jlpoltrack/mLRS-433-DIY/Renders/Back.png

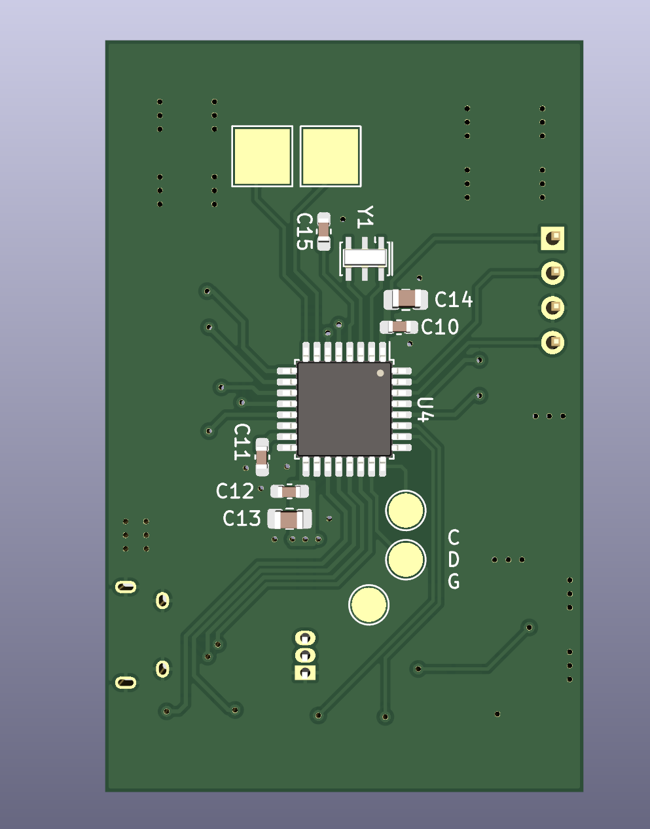
Renders/Back.png
