jlpoltrack/mLRS-433-DIY/Renders/Front.png

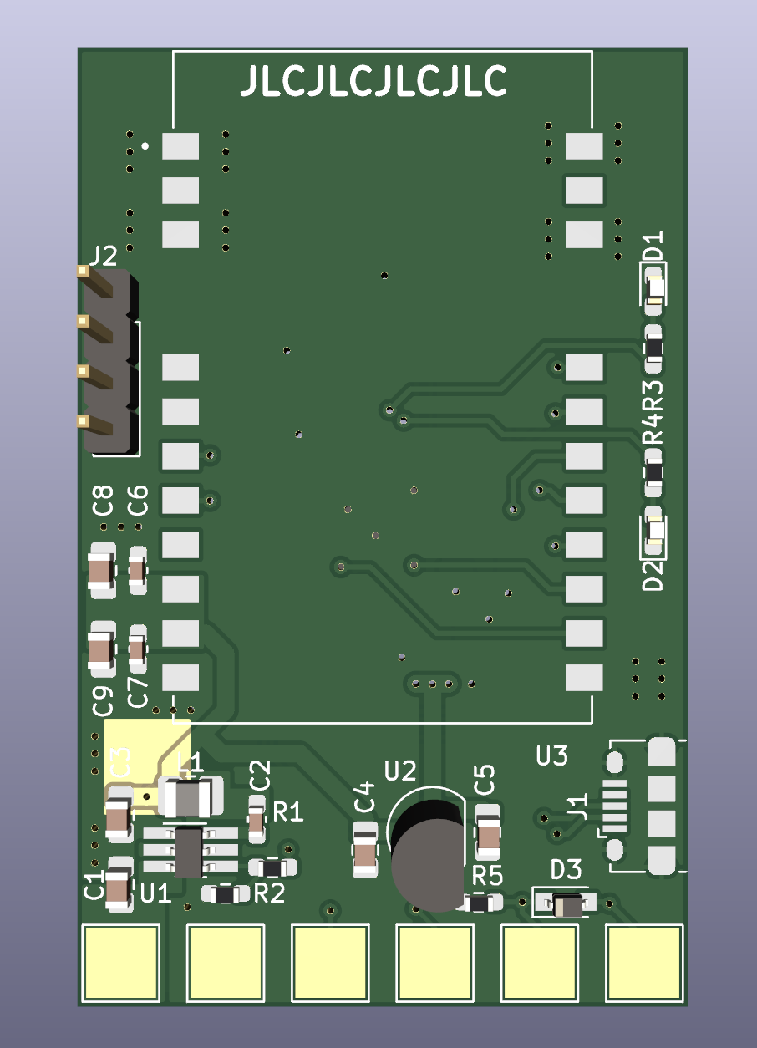
Renders/Front.png
