jlpoltrack/mLRS-433-DIY/E22/E22-900M30S.step

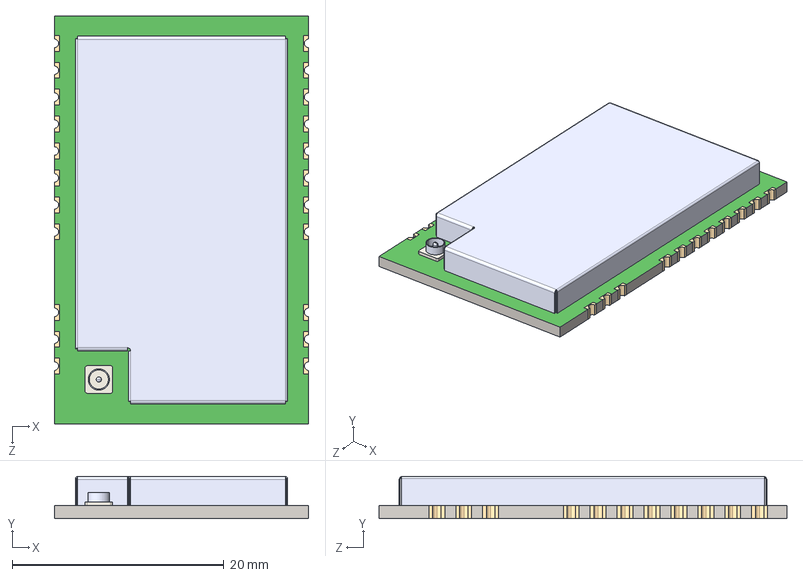
[picture p3: CAD file, 2023-05-28]
E22/E22-900M30S.step
24.0 x 3.97 x 38.5 mm
