jlpoltrack/mLRS-433-DIY/Schematic.pdf

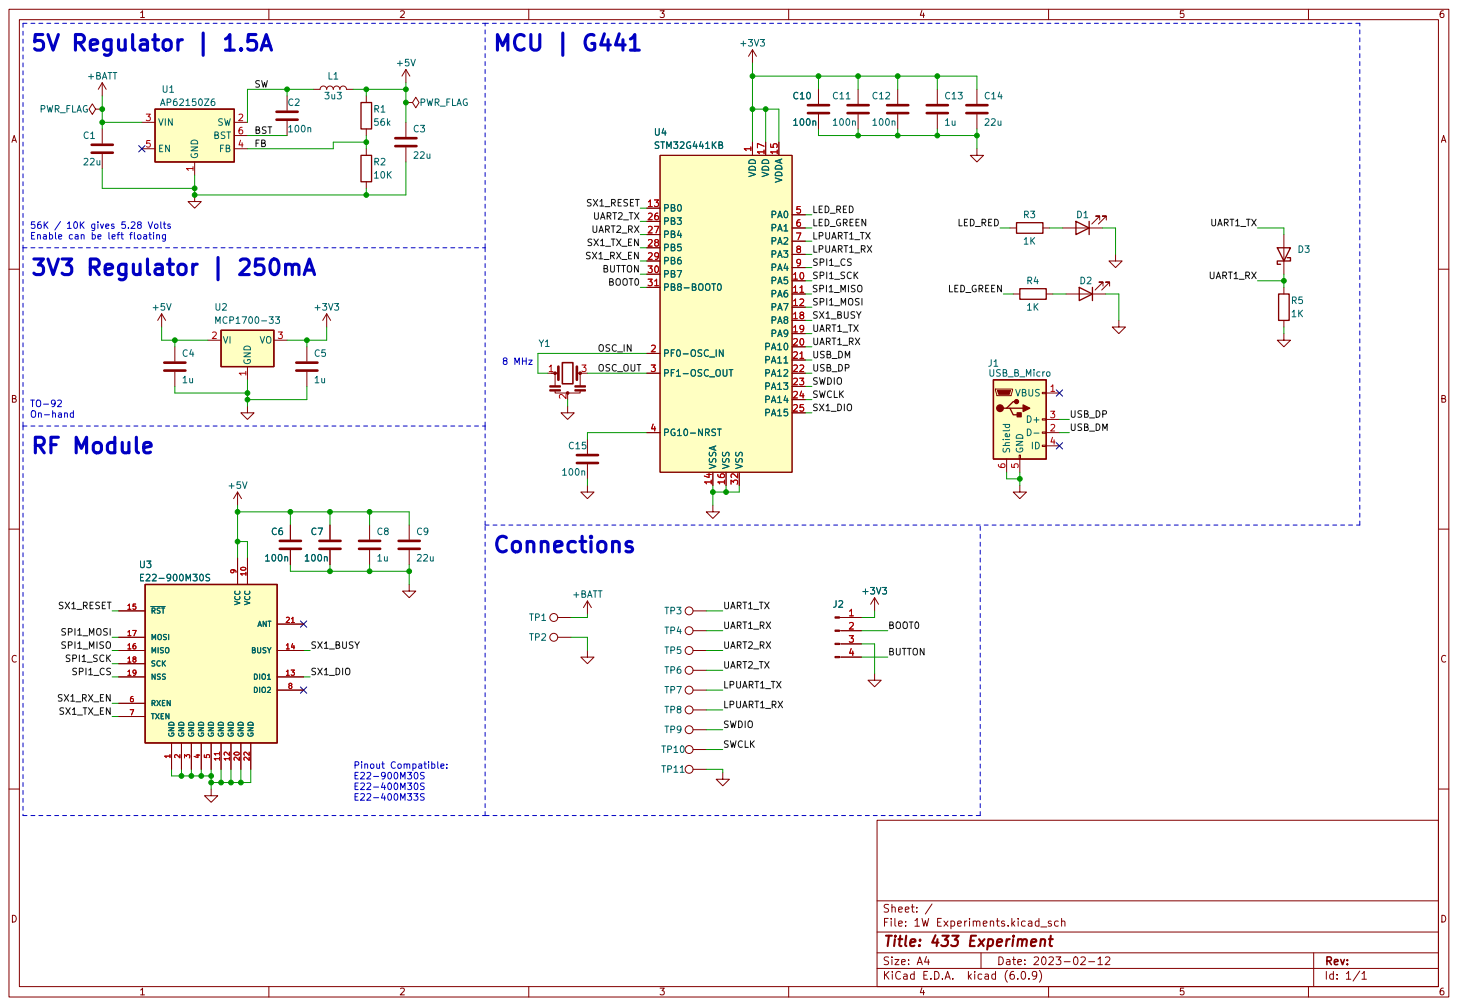
[picture p4: page 1]

Enable can be left floating TO-92 On-hand RF Module
LPUART1_RX 3V3 Regulator | 250mA

1 SW 2 VIN 3 FB 4 EN 5 BST 6 U1AP62150Z6 TP5 TP1 TP2

1 PA5 10 PA6 11 PA7 12 PB0 13 VSSA 14 VDDA 15 VSS 16 VDD 17 PA8 18 PA9 19 PF0-OSC_IN 2 PA10 20 PA11 21 PA12 22 PA13 23 PA14 24 PA15 25 PB3 26 PB4 27 PB5 28 PB6 29 PF1-OSC_OUT 3 PB7 30 PB8-BOOT0 31 VSS 32 PG10-NRST 4 PA0 5 PA1 6 PA2 7 PA3 8 PA4 9 U4STM32G441KB C13

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

1 VCC 10 GND 11 GND 12 DIO1 13 BUSY 14 ~{RST} 15 MISO 16 MOSI 17 SCK 18 NSS 19 GND

2 GND 20 ANT 21 GND 22 GND
