jlpoltrack/mLRS-433-DIY/E22/Schematic 0.1.pdf

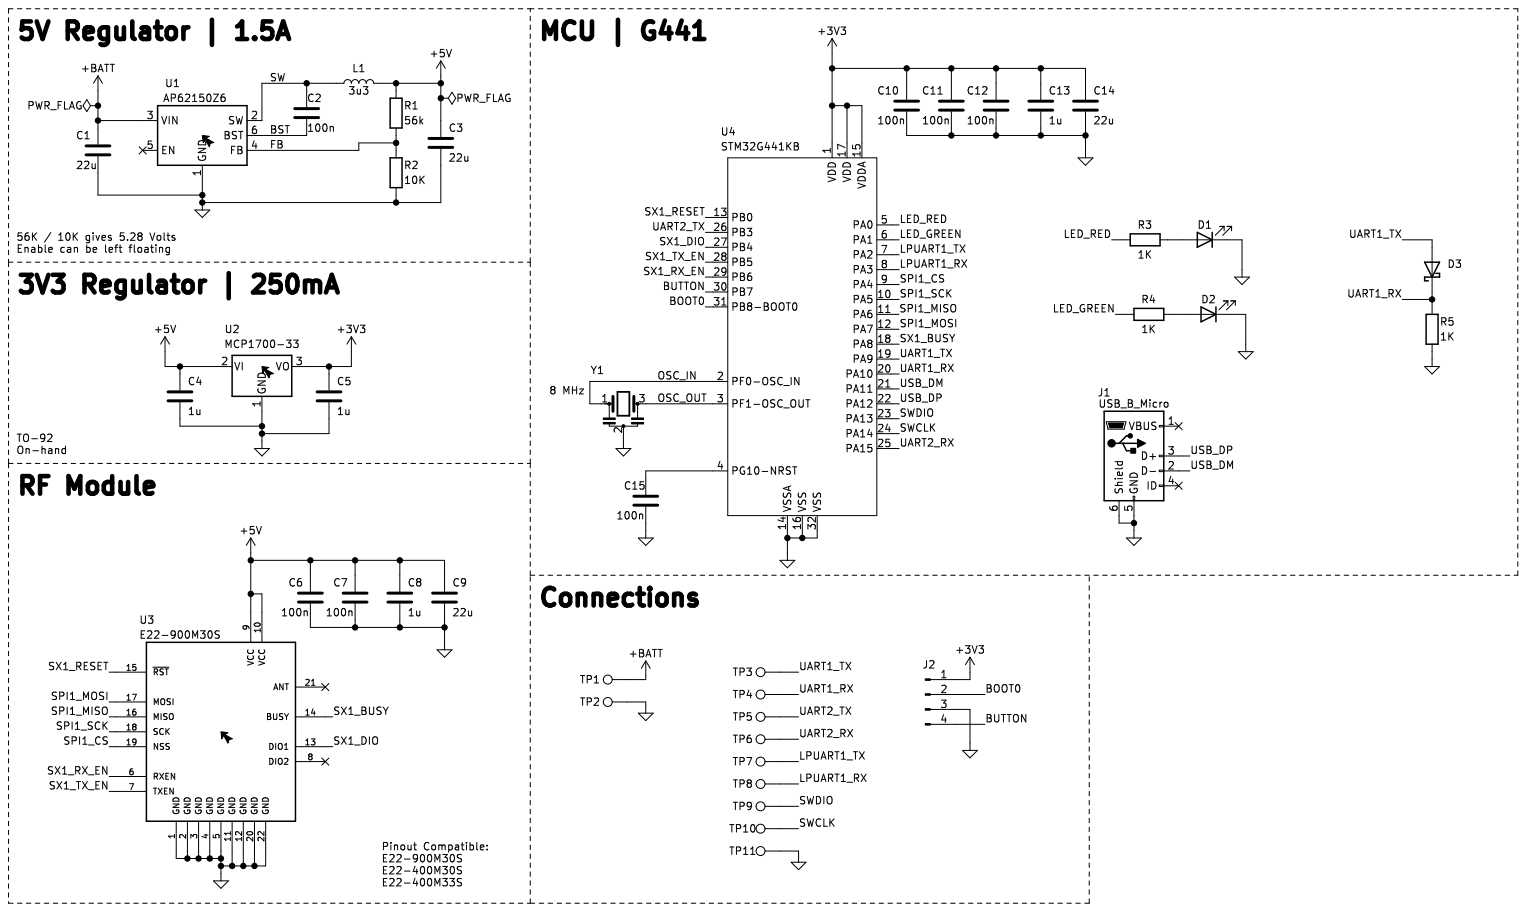
[picture p5: page 1]
