jlpoltrack/mLRS-433-DIY/1W Experiments.kicad_pcb

## KiCad design 1W Experiments.kicad_pcb (2023-05-28)

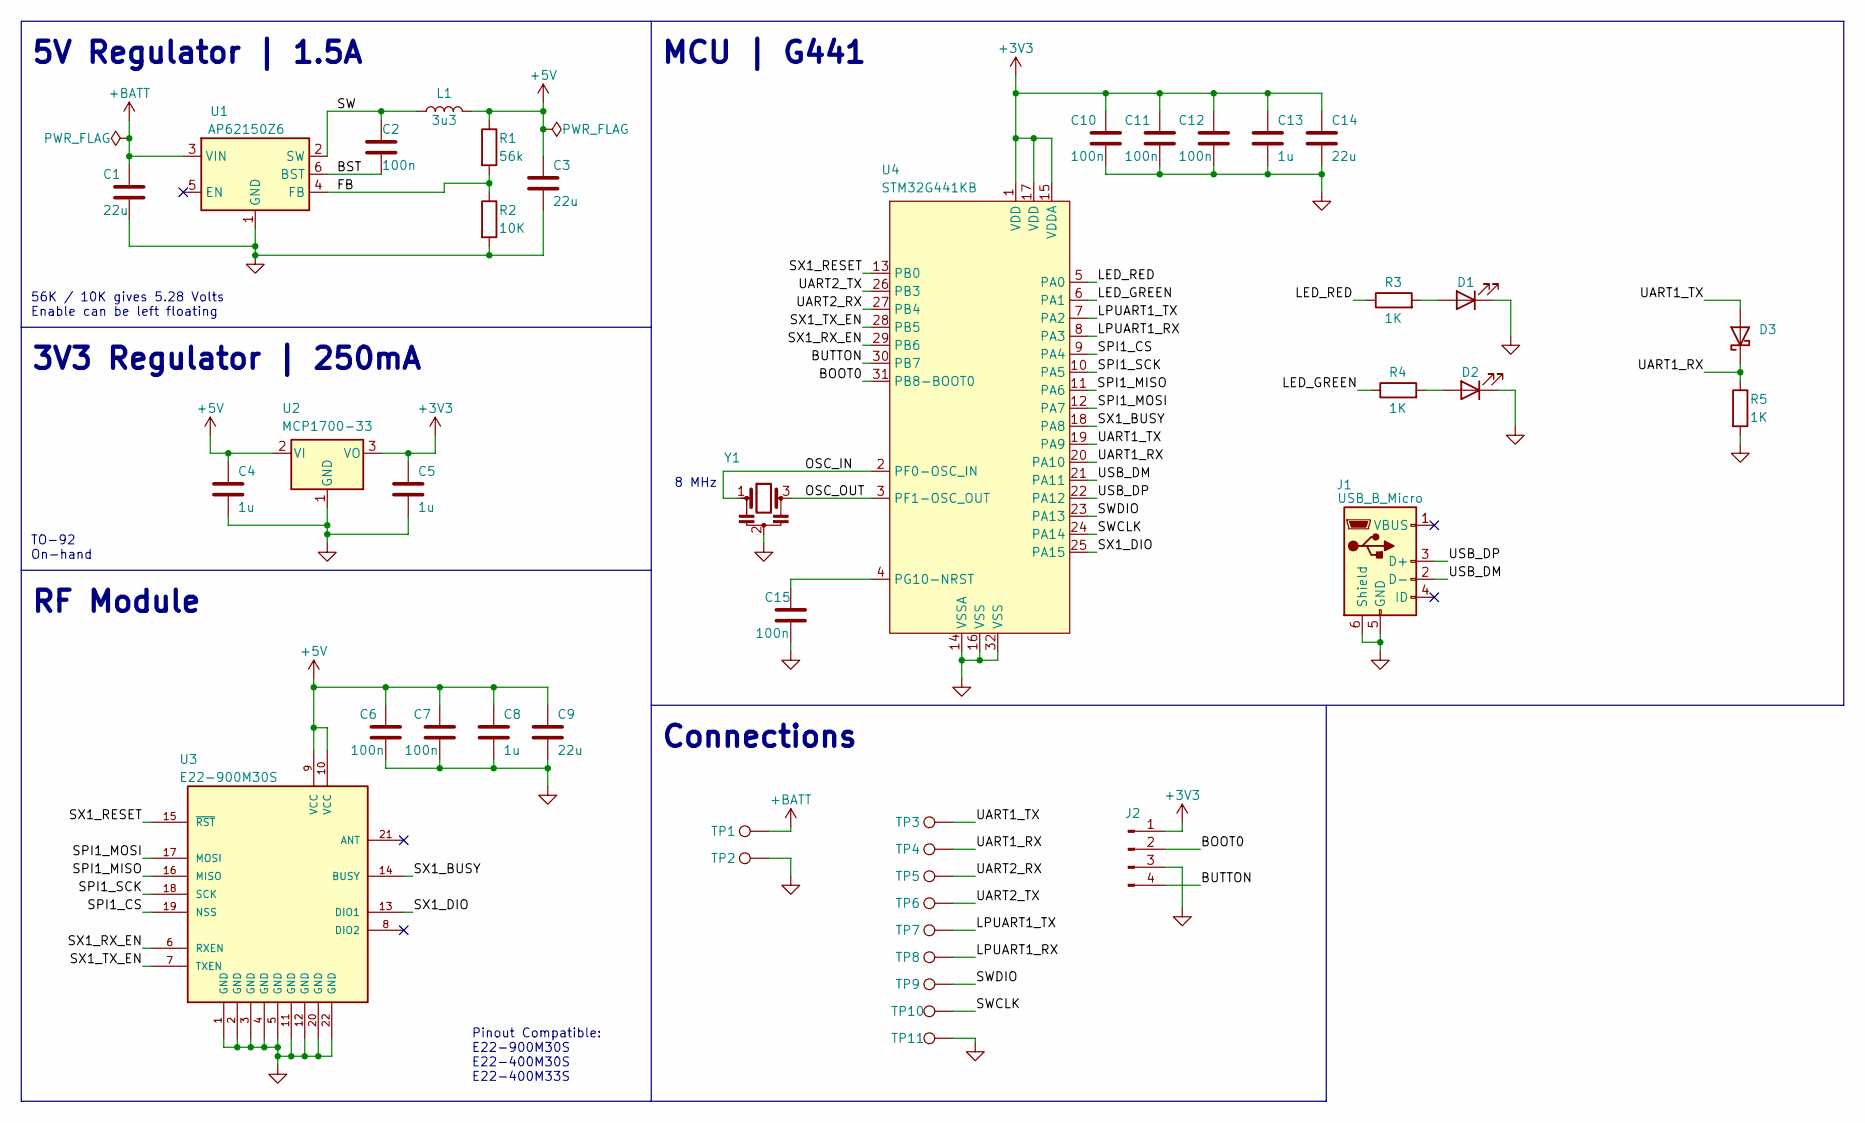
[picture p6: schematic 1W Experiments.kicad_sch, 433 Experiment]

Parts:
C1, C3, C9, C14: 22u; C_0805_2012Metric_Pad1.18x1.45mm_HandSolder
C2, C6, C7, C10, C11, C12, C15: 100n; C_0603_1608Metric_Pad1.08x0.95mm_HandSolder
C4, C5, C8, C13: 1u; C_0805_2012Metric_Pad1.18x1.45mm_HandSolder
D1, D2: LED; LED_0603_1608Metric_Pad1.05x0.95mm_HandSolder
D3: D_Schottky; D_SOD-323_HandSoldering
J1: USB_B_Micro; USB_Micro-B_Amphenol_10118194_Horizontal
J2: Conn_01x04_Male; PinHeader_1x04_P2.54mm_Vertical
L1: 3u3; L_1008_2520Metric_Pad1.43x2.20mm_HandSolder
R1: 56k; R_0603_1608Metric_Pad0.98x0.95mm_HandSolder
R2: 10K; R_0603_1608Metric_Pad0.98x0.95mm_HandSolder
R3, R4, R5: 1K; R_0603_1608Metric_Pad0.98x0.95mm_HandSolder
TP1, TP2, TP3, TP4, TP5, TP6, TP7, TP8: TestPoint; TestPoint_Pad_4.0x4.0mm
TP9, TP10, TP11: TestPoint; TestPoint_Pad_D2.5mm
U1: AP62150Z6; TSOT-23-6_HandSoldering
U2: MCP1700-33; TO-92_Inline
U3: E22-900M30S; XCVR_E22-900M30S; PARTREV 1.2
U4: STM32G441KB; LQFP-32_7x7mm_P0.8mm
Y1: Resonator; Resonator_SMD_Murata_CSTxExxV-3Pin_3.0x1.1mm_HandSoldering

Connections:
+3V3: C5.1, C10.1, C11.1, C12.1, C13.1, C14.1, J2.1, U2.3 (VO), U4.1 (VDD), U4.15 (VDDA), U4.17 (VDD)
+5V: C3.1, C4.1, C6.1, C7.1, C8.1, C9.1, L1.2, R1.1, U2.2 (VI), U3.9 (VCC), U3.10 (VCC)
+BATT: C1.1, TP1.1, U1.3 (VIN)
/BOOT0: J2.2, U4.31 (PB8-BOOT0)
/BST: C2.2, U1.6 (BST)
/BUTTON: J2.4, U4.30 (PB7)
/FB: R1.2, R2.1, U1.4 (FB)
/LED_GREEN: R4.1, U4.6 (PA1)
/LED_RED: R3.1, U4.5 (PA0)
/LPUART1_RX: TP8.1, U4.8 (PA3)
/LPUART1_TX: TP7.1, U4.7 (PA2)
/OSC_IN: U4.2 (PF0-OSC_IN), Y1.1
/OSC_OUT: U4.3 (PF1-OSC_OUT), Y1.3
/SPI1_CS: U3.19 (NSS), U4.9 (PA4)
/SPI1_MISO: U3.16 (MISO), U4.11 (PA6)
/SPI1_MOSI: U3.17 (MOSI), U4.12 (PA7)
/SPI1_SCK: U3.18 (SCK), U4.10 (PA5)
/SW: C2.1, L1.1, U1.2 (SW)
/SWCLK: TP10.1, U4.24 (PA14)
/SWDIO: TP9.1, U4.23 (PA13)
/SX1_BUSY: U3.14 (BUSY), U4.18 (PA8)
/SX1_DIO: U3.13 (DIO1), U4.25 (PA15)
/SX1_RESET: U3.15 (~RST), U4.13 (PB0)
/SX1_RX_EN: U3.6 (RXEN), U4.29 (PB6)
/SX1_TX_EN: U3.7 (TXEN), U4.28 (PB5)
/UART1_RX: D3.1 (K), R5.1, TP4.1, U4.20 (PA10)
/UART1_TX: D3.2 (A), TP3.1, U4.19 (PA9)
/UART2_RX: TP5.1, U4.27 (PB4)
/UART2_TX: TP6.1, U4.26 (PB3)
/USB_DM: J1.2 (D-), U4.21 (PA11)
/USB_DP: J1.3 (D+), U4.22 (PA12)
GND: C1.2, C3.2, C4.2, C5.2, C6.2, C7.2, C8.2, C9.2, C10.2, C11.2, C12.2, C13.2, C14.2, C15.2, D1.1 (K), D2.1 (K), J1.5 (GND), J1.6 (Shield), J2.3, R2.2, R5.2, TP2.1, TP11.1, U1.1 (GND), U2.1 (GND), U3.1 (GND), U3.2 (GND), U3.3 (GND), U3.4 (GND), U3.5 (GND), U3.11 (GND), U3.12 (GND), U3.20 (GND), U3.22 (GND), U4.14 (VSSA), U4.16 (VSS), U4.32 (VSS), Y1.2
unnamed: C15.1, U4.4 (PG10-NRST)
unnamed: D1.2 (A), R3.2
unnamed: D2.2 (A), R4.2

Notes on the sheet:
56K / 10K gives 5.28 Volts Enable can be left floating
Connections
Pinout Compatible: E22-900M30S E22-400M30S E22-400M33S
5V Regulator | 1.5A
3V3 Regulator | 250mA
8 MHz
MCU | G441
RF Module
TO-92 On-hand

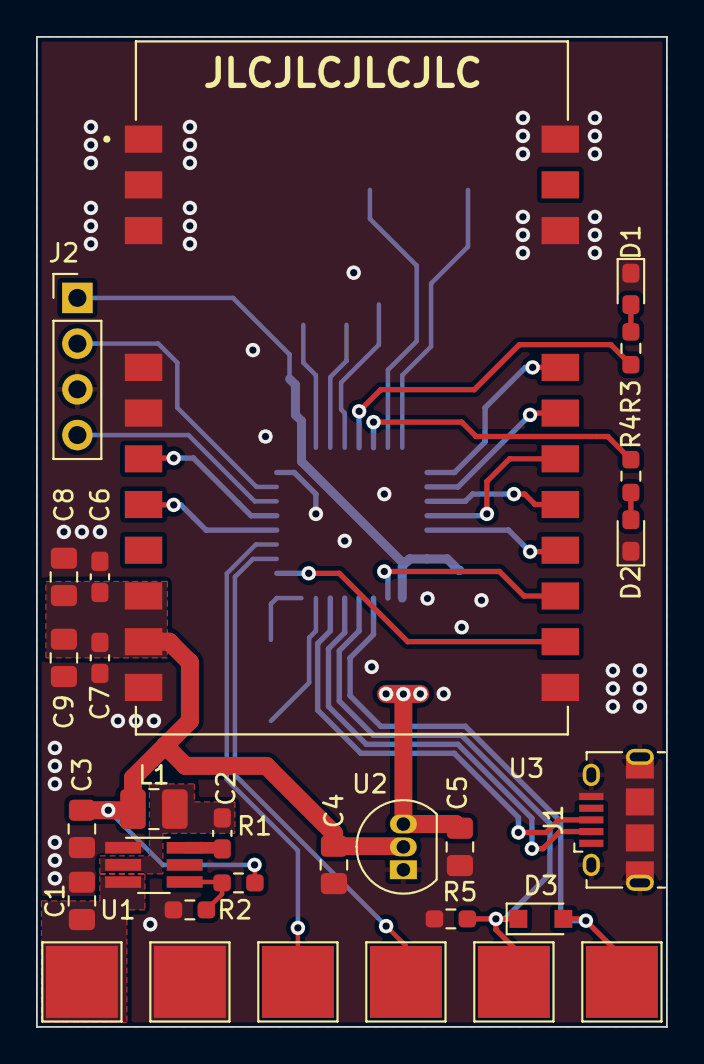
[picture p7: board 1W Experiments.kicad_pcb from above]

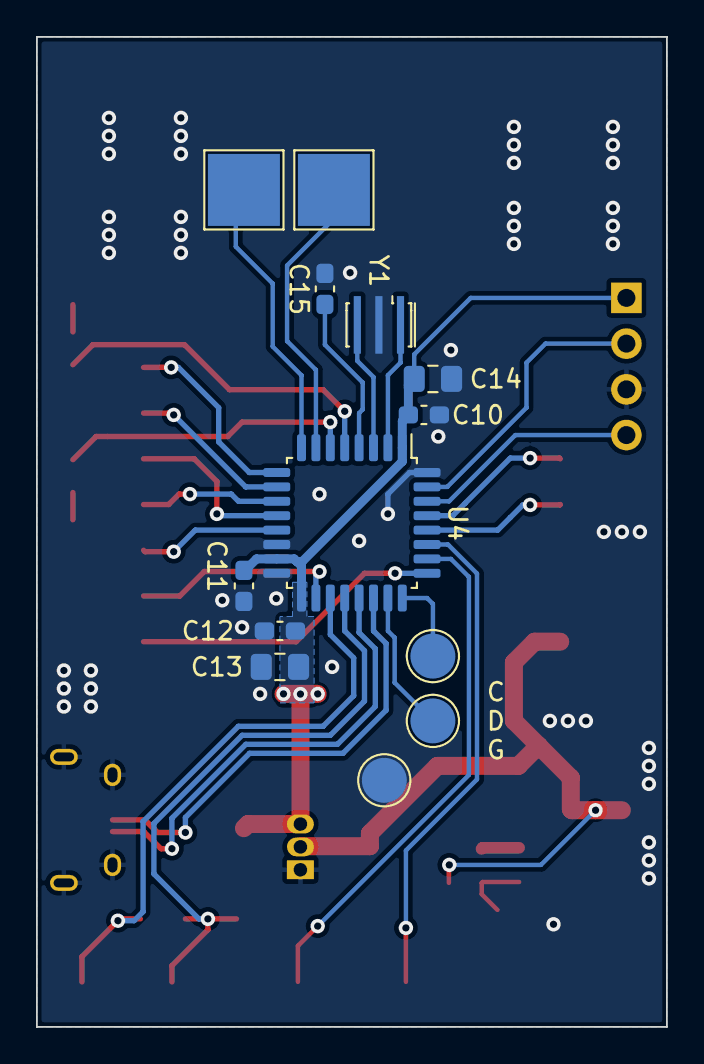
[picture p8: board 1W Experiments.kicad_pcb from below]

Board: 2 copper layers, 35.0 x 55.0 mm, 42 parts (13 on the bottom side), 35 nets.
